yeo-menghan/CG2111A/README.md

# CG2111A

https://nusmods.com/modules/CG2111A/engineering-principles-and-practice-ii
<br>
Alex rescue robot - usage of Arduino, Raspberry Pi and ROS
