yeo-menghan/CG2111A/Alex/Encoder.ino

/*
   Setup and start codes for external interrupts and
   pullup resistors.

*/
// Enable pull up resistors on pins 2 and 3
void enablePullups()
{
  // Use bare-metal to enable the pull-up resistors on pins
  // 2 and 3. These are pins PD2 and PD3 respectively.
  // We set bits 2 and 3 in DDRD to 0 to make them inputs.
//  DDRD &= 0b11110011;
  DDRD |= 0b00000000;
  PORTD |= 0b00001100;
}

// Functions to be called by INT0 and INT1 ISRs.
void leftISR()
{
  if (dir == FORWARD) {
    leftForwardTicks++;
    forwardDist = (unsigned long) ((float) leftForwardTicks / COUNTS_PER_REV * WHEEL_CIRC);
  }
  else if (dir == BACKWARD) {
    leftReverseTicks++;
    reverseDist = (unsigned long) ((float) leftReverseTicks / COUNTS_PER_REV * WHEEL_CIRC);
  }
  else if (dir == LEFT) {
    leftReverseTicksTurns++;
  }
  else if (dir == RIGHT) {
    leftForwardTicksTurns++;
  }
  // TODO
//    if (leftTicks % COUNTS_PER_REV_L == 0) {
//      dbprintf("LEFT: ");
//     dbprintf(leftTicks / COUNTS_PER_REV_L);
//    }
}

void rightISR()
{
  if (dir == FORWARD) {
    rightForwardTicks++;
    //forwardDist = (unsigned long) ((float) leftForwardTicks / COUNTS_PER_REV * WHEEL_CIRC);
  }
  else if (dir == BACKWARD) {
    rightReverseTicks++;
    //reverseDist = (unsigned long) ((float) leftReverseTicks / COUNTS_PER_REV * WHEEL_CIRC);
  }
  else if (dir == LEFT) {
    rightForwardTicksTurns++;
  }
  else if (dir == RIGHT) {
    rightReverseTicksTurns++;
  }
}

// Set up the external interrupt pins INT0 and INT1
// for falling edge triggered. Use bare-metal.
void setupEINT()
{
  // Use bare-metal to configure pins 2 and 3 to be
  // falling edge triggered. Remember to enable
  // the INT0 and INT1 interrupts.
  EICRA = 0b1010;
  EIMSK = 0b11;
}

// Implement the external interrupt ISRs below.
// INT0 ISR should call leftISR while INT1 ISR
// should call rightISR.
ISR(INT0_vect) {
  leftISR();
}

ISR(INT1_vect) {
  rightISR();
}
