yeo-menghan/CG2111A/Alex/Communications.ino

/*
   Alex Communication Routines.
*/

TResult readPacket(TPacket *packet)
{
  // Reads in data from the serial port and
  // deserializes it.Returns deserialized
  // data in "packet".

  char buffer[PACKET_SIZE];
  int len;

  len = readSerial(buffer);

  if (len == 0)
    return PACKET_INCOMPLETE;
  else
    return deserialize(buffer, len, packet);

}

void sendResponse(TPacket *packet)
{
  // Takes a packet, serializes it then sends it out
  // over the serial port.
  char buffer[PACKET_SIZE];
  int len;

  len = serialize(buffer, packet, sizeof(TPacket));
  writeSerial(buffer, len);
}


/*
   Setup and start codes for serial communications

*/

// Set up the serial connection. For now we are using
// Arduino Wiring, you will replace this later
// with bare-metal code.
void setupSerial()
{
  // To replace later with bare-metal.
  Serial.begin(9600);
}

// Start the serial connection. For now we are using
// Arduino wiring and this function is empty. We will
// replace this later with bare-metal code.

void startSerial()
{
  // Empty for now. To be replaced with bare-metal code
  // later on.

}

// Read the serial port. Returns the read character in
// ch if available. Also returns TRUE if ch is valid.
// This will be replaced later with bare-metal code.

int readSerial(char *buffer)
{

  int count = 0;

  while (Serial.available())
    buffer[count++] = Serial.read();

  return count;
}

// Write to the serial port. Replaced later with
// bare-metal code

void writeSerial(const char *buffer, int len)
{
  Serial.write((const uint8_t*)buffer, len);
}
