yeo-menghan/CG2111A/Alex/Utility.ino

void waitForHello()
{
  int exit = 0;

  while (!exit)
  {
    TPacket hello;
    TResult result;

    do
    {
      result = readPacket(&hello);
    } while (result == PACKET_INCOMPLETE);

    if (result == PACKET_OK)
    {
      if (hello.packetType == PACKET_TYPE_HELLO)
      {


        sendOK();
        exit = 1;
      }
      else
        sendBadResponse();
    }
    else if (result == PACKET_BAD)
    {
      sendBadPacket();
    }
    else if (result == PACKET_CHECKSUM_BAD)
      sendBadChecksum();
  } // !exit
}

// Clears all our counters
void clearCounters()
{
  leftForwardTicks = 0;
  rightForwardTicks = 0;
  leftReverseTicks = 0;
  rightReverseTicks = 0;
  leftForwardTicksTurns = 0;
  rightForwardTicksTurns = 0;
  leftReverseTicksTurns = 0;
  rightReverseTicksTurns = 0;
  forwardDist = 0;
  reverseDist = 0;
}

// Clears one particular counter  char padding[3];

void clearOneCounter(int which)
{
  clearCounters();
}
// Intialize Vincet's internal states

void initializeState()
{
  clearCounters();
}
